petegaggs/MIDI-to-CV/MIDI-CV internals.jpg

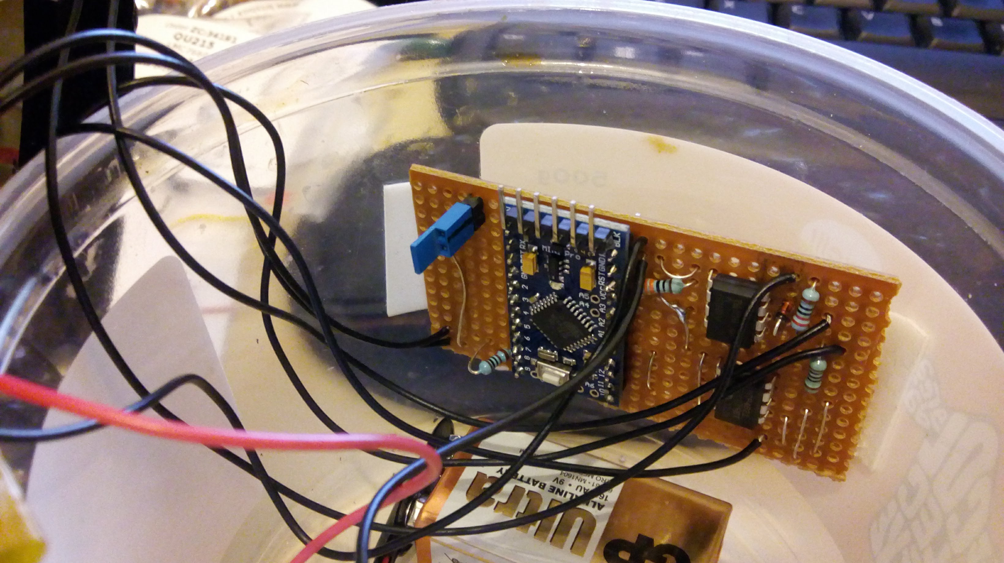
MIDI-CV internals.jpg
