petegaggs/MIDI-to-CV/midi_cv.jpg

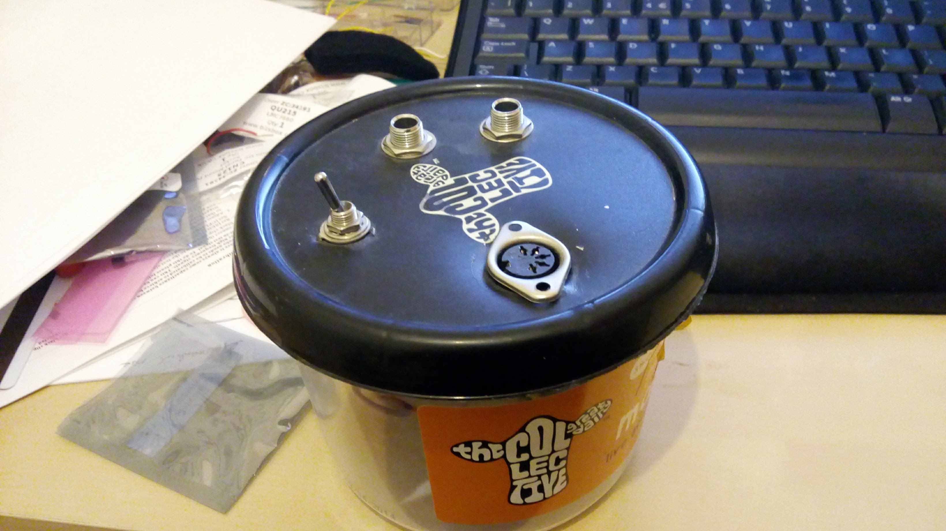
midi_cv.jpg
