petegaggs/MIDI-to-CV/README.md

# MIDI-to-CV
arduino based MIDI to CV converter
2 variants:
Original hardware was simple 1V/octave midi to CV converter
New version is combined Midi-CV plus AS3340 VCO module
