petegaggs/MIDI-to-CV/OSC_3340_A_BOM.xlsx

Description | Designator | Quantity | Supplier / Part Number
OSC_3340 Bill of Materials
rev A
Capacitors
Capacitor 0805 X7R 10% 50V 100nF | C1, C2, C3, C4, C8, C9, C10, C11, C12, C16 | 10
Capacitor Electrolytic 10uF 16V 5x11mm | C5, C6, C7 | 3
Capacitor 0805 X7R 10% 50V 10nF | C13, C17 | 2
Capacitor 0805 NPO 5% 100V 22pF | C14, C15 | 2
Capacitor Polyester WIMA FKS2 1nF 5% 100V | C18 | 1
Connectors
Jack socket 3.5mm mono | J1, J4, J7, J8, J9 | 5 | Soundtronics / 7212-239
Pin header 2.54mm pitch 1x6 way | J3 | 1
Jack socket 3.5mm stereo | J5 | 1 | Soundtronics / 7212-240
Pin header 2.54mm pitch 1x2 way | J6 | 1
Semiconductors
Diode 1N4148 | D1 | 1
Transistor NPN 2N3904 TO-92 | Q1 | 1
IC Quad Op-amp TL084 DIP-14 package | U1 | 1
IC Voltage Controlled Oscillator Alfa AS3340A DIP-16 pakage | U2 | 1 | Soundtronics / 7212-601
IC Adjustable Precision shunt regulator 1% TL431ACLP TO-92 | U3 | 1 | TI / TL431ACLP
Voltage regulator -5V LM79L05 TO92 package | U4 | 1
IC Microcontroller Atmel ATMEGA328P-PU | U5 | 1
IC 12-bit dual SPI DAC MCP4822-E/P | U6 | 1 | Microchip / MCP4822-E/P
IC 6N139M Opto Isolator DIP-8 | U7 | 1
Resistors
Resistor 0805 1% 0.125W 220R | R18 | 1
Resistor 0805 1% 0.125W 330R | R29 | 1
Resistor 0805 1% 0.125W 470R | R11, R13, R16, R32, R33, R35 | 6
Resistor 0805 1% 0.125W 1K8 | R17 | 1
Resistor 0805 1% 0.125W 2K | R8 | 1
Resistor 0805 1% 0.125W 3K3 | R7, R9 | 2
Resistor 0805 1% 0.125W 5K6 | R2 | 1
Resistor 0805 1% 0.125W 10K | R12, R25, R26, R27, R28, R34 | 6
Resistor 0805 1% 0.125W 15K | R22, R31 | 2
Resistor 0805 1% 0.125W 18K | R20, R24 | 2
Resistor 0805 1% 0.125W 24K | R1 | 1
Resistor 0805 1% 0.125W 30K | R21, R23, R30 | 3
Resistor 0805 1% 0.125W 33K | R19 | 1
Resistor 0805 1% 0.125W 51K | R10 | 1
Resistor 0805 1% 0.125W 91K | R14 | 1
Resistor 0805 1% 0.125W 100K | R3, R5 | 2
Resistor 0805 1% 0.125W 240K | R4 | 1
Resistor 0805 1% 0.125W 1M | R6, R15 | 2
Poteniometer 9mm 100K linear | RV1, RV4 | 2 | Soundtronics / 7300-785
Preset Potentiometer SIL vertical Bourns 3296W 10K | RV2 | 1 | Soundtronics / 7212-857
Preset Potentiometer SIL vertical Bourns 3296W 20K | RV3, RV5 | 2 | Soundtronics / 7212-858
Crystals
Crystal HC-49 16.000MHz low profile | Y1 | 1
