petegaggs/MIDI-to-CV/osc_3340_schematic_revA.pdf

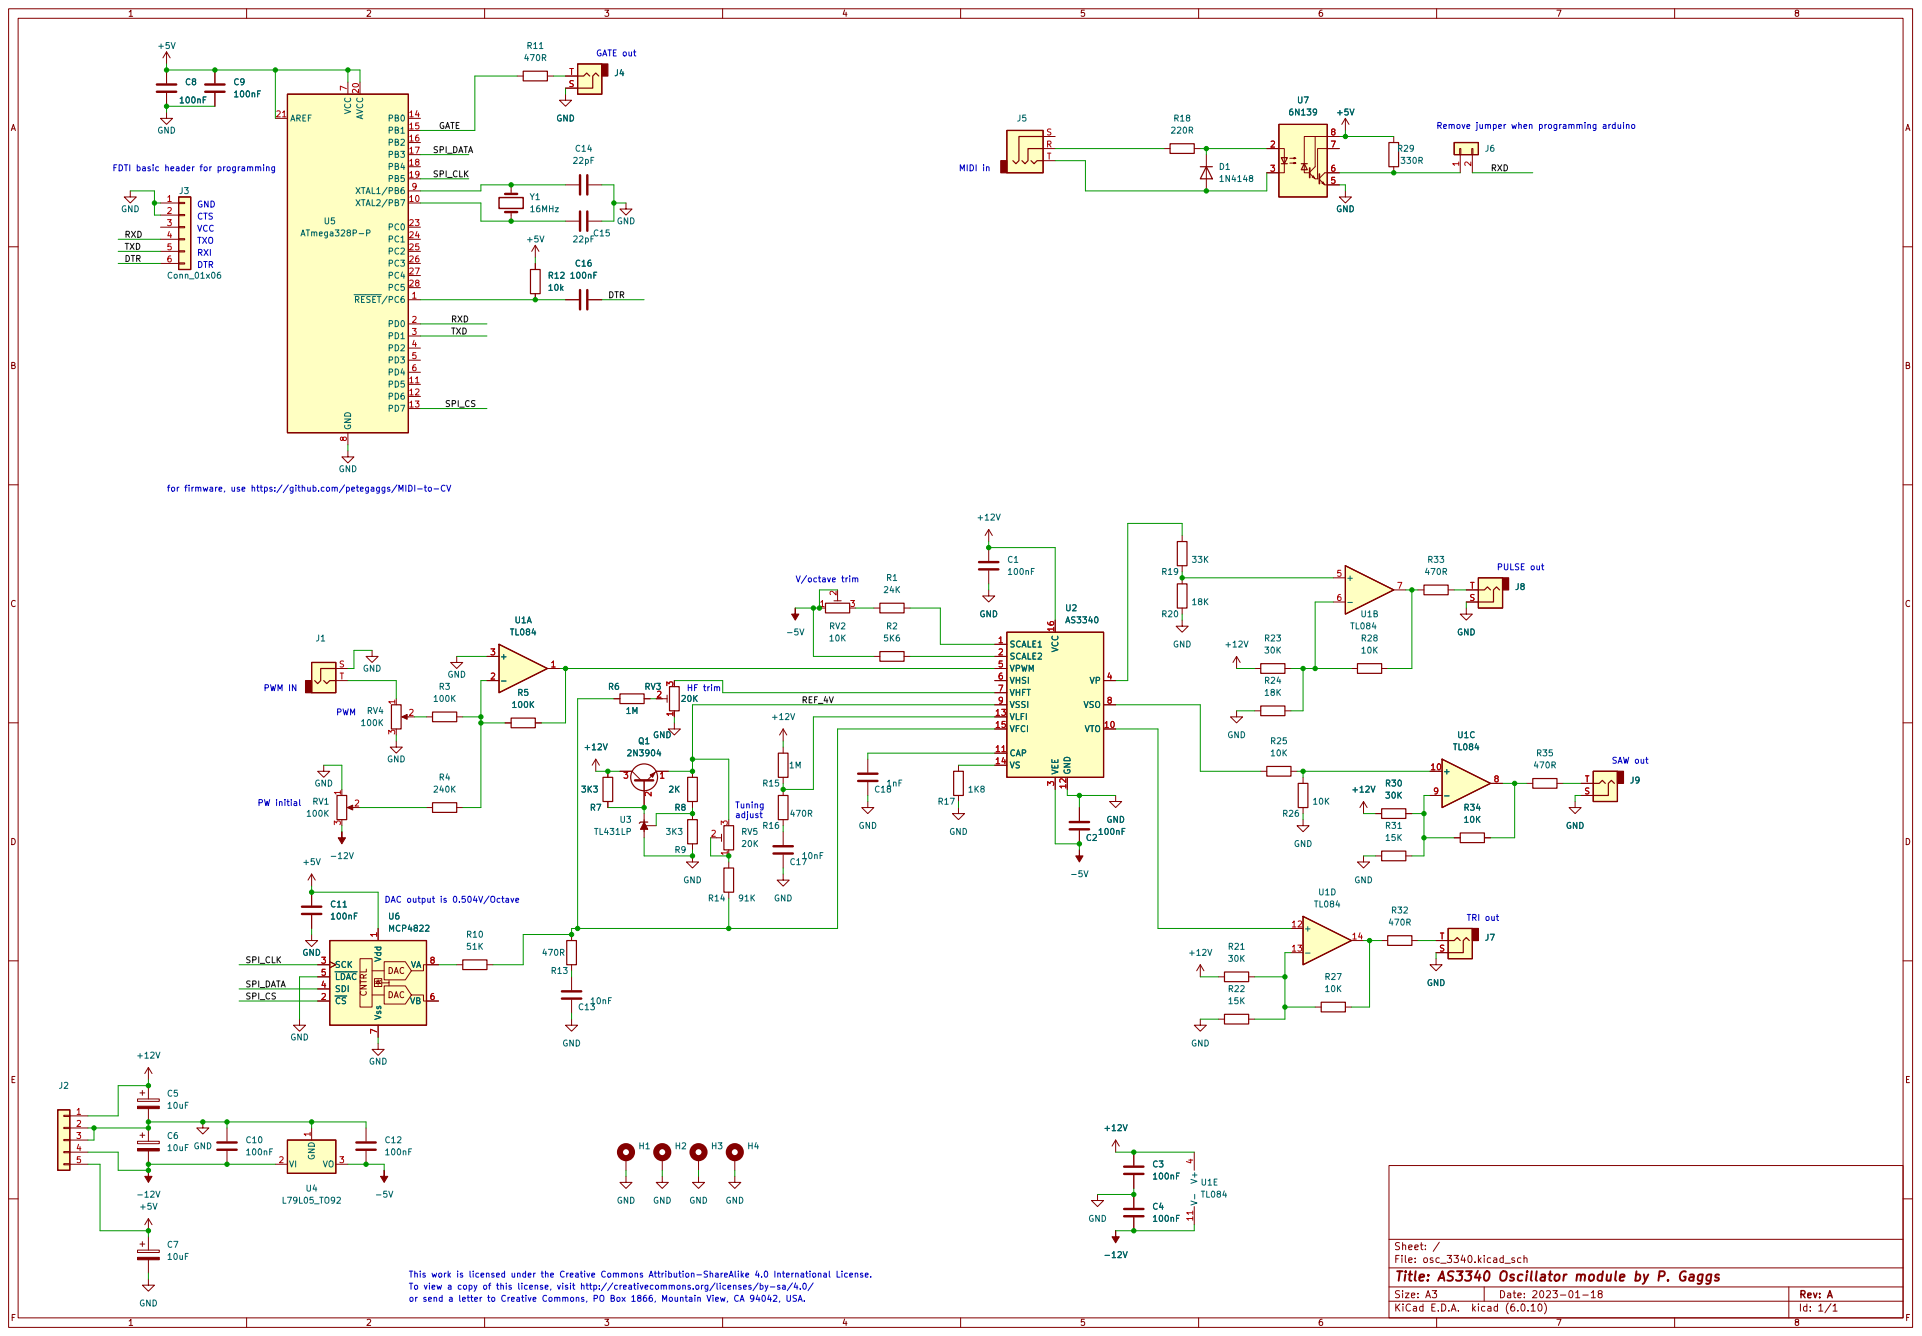
[picture p3: page 1]

Remove jumper when programming arduino GATE out

SPI_DATA RXD
FDTI basic header for programming

for firmware, use https://github.com/petegaggs/MIDI-to-CV

PULSE out PWM IN

TRI out V/octave trim

File: osc_3340.kicad_sch Sheet: /
Id: 1/1 Title: AS3340 Oscillator module by P. Gaggs

This work is licensed under the Creative Commons Attribution-ShareAlike 4.0 International License.
or send a letter to Creative Commons, PO Box 1866, Mountain View, CA 94042, USA. To view a copy of this license, visit http://creativecommons.org/licenses/by-sa/4.0/
