petegaggs/MIDI-to-CV/midi-cv.pdf

+5V

+5V

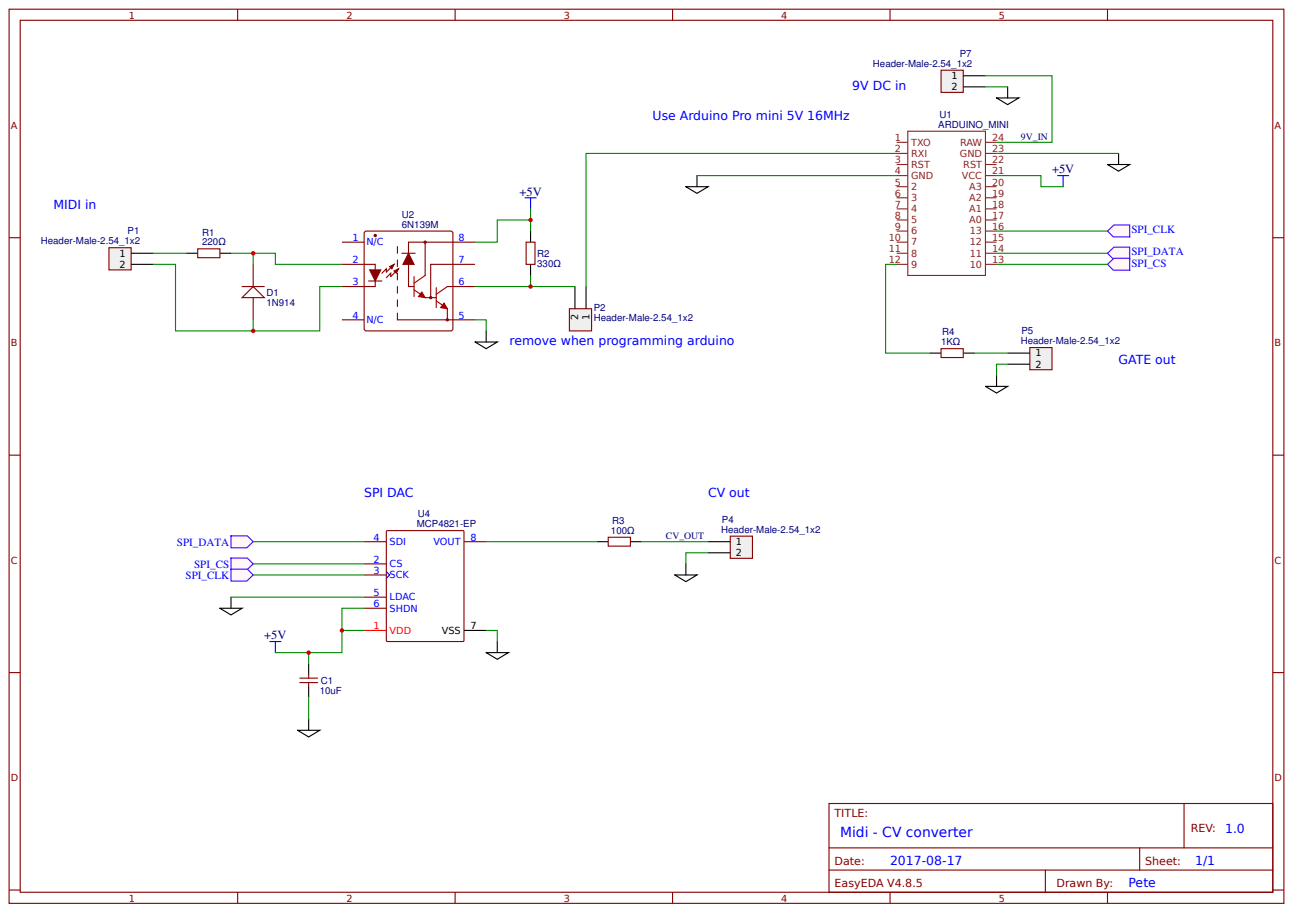
[picture p4: page 1]

Use Arduino Pro mini 5V 16MHz

remove when programming arduino
