petegaggs/MIDI-to-CV/osc_3340.kicad_pcb

## KiCad design osc_3340.kicad_pcb (2023-04-07)

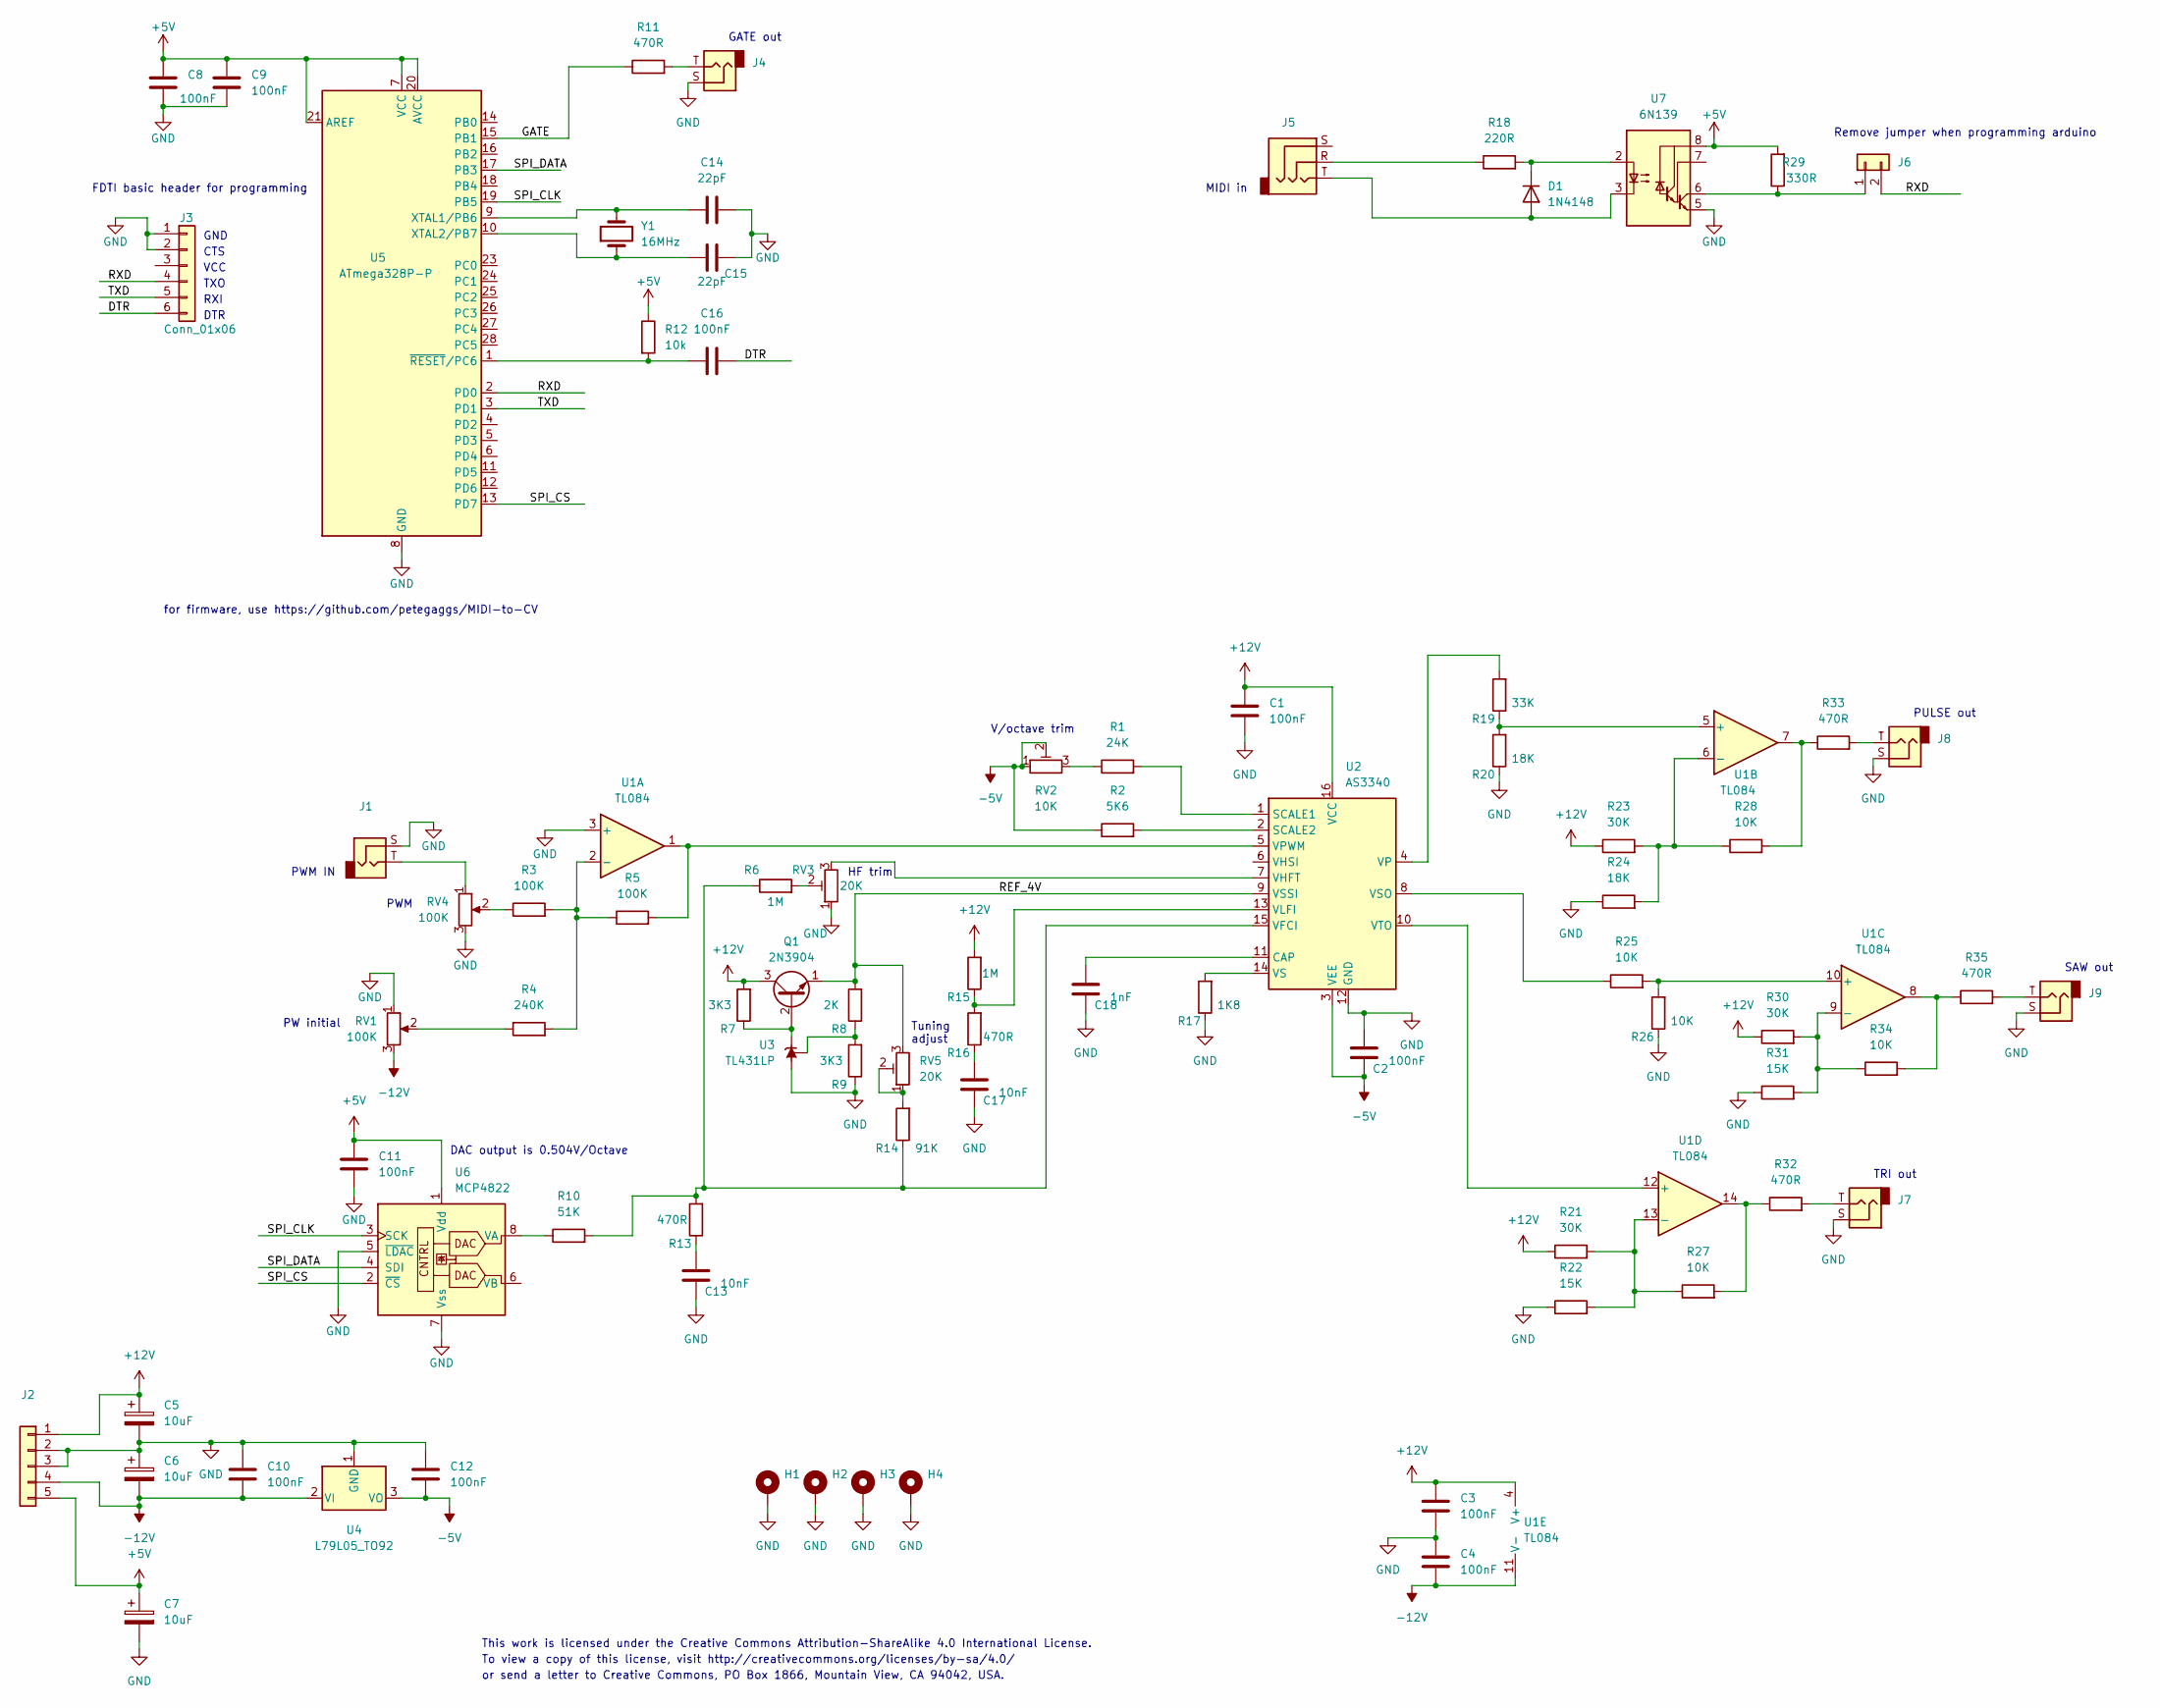
[picture p5: schematic osc_3340.kicad_sch, AS3340 Oscillator module by P. Gaggs]

Parts:
C1, C2, C3, C4, C8, C9, C10, C11, C12, C16: 100nF; C_0805_2012Metric_Pad1.18x1.45mm_HandSolder
C5, C6, C7: 10uF; CP_Radial_D5.0mm_P2.00mm
C13, C17: 10nF; C_0805_2012Metric_Pad1.18x1.45mm_HandSolder
C14, C15: 22pF; C_0805_2012Metric_Pad1.18x1.45mm_HandSolder
C18: 1nF; C_Disc_D6.0mm_W4.4mm_P5.00mm
D1: 1N4148; D_DO-35_SOD27_P7.62mm_Horizontal
H1, H2, H3, H4: MountingHole_Pad; MountingHole_3.2mm_M3_ISO7380_Pad
J1, J4, J7, J8, J9: AudioJack2; jack_3.5mm_mono_vertical_soundtronics_7212-239
J2: Conn_01x05; PinHeader_1x05_P2.54mm_Vertical
J3: Conn_01x06; PinHeader_1x06_P2.54mm_Vertical
J5: AudioJack3; jack_3.5mm_stereo_vertical_soundtronics_7212-240
J6: Conn_01x02; PinHeader_1x02_P2.54mm_Vertical
Q1: 2N3904; TO-92_Inline_Wide
R1: 24K; R_0805_2012Metric_Pad1.20x1.40mm_HandSolder
R2: 5K6; R_0805_2012Metric_Pad1.20x1.40mm_HandSolder
R3, R5: 100K; R_0805_2012Metric_Pad1.20x1.40mm_HandSolder
R4: 240K; R_0805_2012Metric_Pad1.20x1.40mm_HandSolder
R6, R15: 1M; R_0805_2012Metric_Pad1.20x1.40mm_HandSolder
R7, R9: 3K3; R_0805_2012Metric_Pad1.20x1.40mm_HandSolder
R8: 2K; R_0805_2012Metric_Pad1.20x1.40mm_HandSolder
R10: 51K; R_0805_2012Metric_Pad1.20x1.40mm_HandSolder
R11, R13, R16, R32, R33, R35: 470R; R_0805_2012Metric_Pad1.20x1.40mm_HandSolder
R12: 10k; R_0805_2012Metric_Pad1.20x1.40mm_HandSolder
R14: 91K; R_0805_2012Metric_Pad1.20x1.40mm_HandSolder
R17: 1K8; R_0805_2012Metric_Pad1.20x1.40mm_HandSolder
R18: 220R; R_0805_2012Metric_Pad1.20x1.40mm_HandSolder
R19: 33K; R_0805_2012Metric_Pad1.20x1.40mm_HandSolder
R20, R24: 18K; R_0805_2012Metric_Pad1.20x1.40mm_HandSolder
R21, R23, R30: 30K; R_0805_2012Metric_Pad1.20x1.40mm_HandSolder
R22, R31: 15K; R_0805_2012Metric_Pad1.20x1.40mm_HandSolder
R25, R26, R27, R28, R34: 10K; R_0805_2012Metric_Pad1.20x1.40mm_HandSolder
R29: 330R; R_0805_2012Metric_Pad1.20x1.40mm_HandSolder
RV1, RV4: 100K; Potentiometer_Alps_RK09K_Single_Vertical
RV2: 10K; Potentiometer_Bourns_3296W_Vertical
RV3, RV5: 20K; Potentiometer_Bourns_3296W_Vertical
U1: TL084; DIP-14_W7.62mm_Socket
U2: AS3340; DIP-16_W7.62mm_Socket
U3: TL431LP; TO-92_Inline_Wide
U4: L79L05_TO92; TO-92_Inline_Wide
U5: ATmega328P-P; DIP-28_W7.62mm
U6: MCP4822; DIP-8_W7.62mm_Socket
U7: 6N139; DIP-8_W7.62mm_Socket
Y1: 16MHz; Crystal_HC49-4H_Vertical

Connections:
+5V: C7.1, C8.1, C9.1, C11.1, J2.5, R12.1, R29.2, U5.7 (VCC), U5.20 (AVCC), U5.21 (AREF), U6.1 (Vdd), U7.8 (VCC)
+12V: C1.1, C3.1, C5.1, J2.1, Q1.3 (C), R7.2, R15.2, R21.1, R23.1, R30.1, U1.4 (V+), U2.16 (VCC)
-5V: C2.2, C12.2, R2.1, RV2.1, RV2.2, U2.3 (VEE), U4.3 (VO)
-12V: C4.2, C6.2, C10.2, J2.4, RV1.3, U1.11 (V-), U4.2 (VI)
/DTR: C16.2, J3.6
/GATE: R11.1, U5.15 (PB1)
/REF_4V: Q1.1 (E), R8.2, RV5.3, U2.9 (VSSI)
/RXD: J3.4, J6.2, U5.2 (PD0)
/SPI_CLK: U5.19 (PB5), U6.3 (SCK)
/SPI_CS: U5.13 (PD7), U6.2 (~CS)
/SPI_DATA: U5.17 (PB3), U6.4 (SDI)
/TXD: J3.5, U5.3 (PD1)
GND: C1.2, C2.1, C3.2, C4.1, C5.2, C6.1, C7.2, C8.2, C9.2, C10.1, C11.2, C12.1, C13.2, C14.2, C15.2, C17.2, C18.2, H1.1, H2.1, H3.1, H4.1, J1.S, J2.2, J2.3, J3.1, J3.2, J4.S, J7.S, J8.S, J9.S, R9.1, R17.1, R20.1, R22.1, R24.1, R26.1, R31.1, RV1.1, RV3.1, RV4.3, U1.3 (+), U2.12 (GND), U3.2 (A), U4.1 (GND), U5.8 (GND), U5.22 (GND), U6.5 (~LDAC), U6.7 (Vss), U7.5 (GND)
unnamed: C13.1, R13.1
unnamed: C14.1, U5.9 (XTAL1/PB6), Y1.2
unnamed: C15.1, U5.10 (XTAL2/PB7), Y1.1
unnamed: C16.1, R12.2, U5.1 (~RESET/PC6)
unnamed: C17.1, R16.1
unnamed: C18.1, U2.11 (CAP)
unnamed: D1.1 (K), R18.2, U7.2 (C1)
unnamed: D1.2 (A), J5.T, U7.3 (C2)
unnamed: J1.T, RV4.1
unnamed: J4.T, R11.2
unnamed: J5.R, R18.1
unnamed: J6.1, R29.1, U7.6 (VO2)
unnamed: J7.T, R32.2
unnamed: J8.T, R33.2
unnamed: J9.T, R35.2
unnamed: Q1.2 (B), R7.1, U3.3 (K)
unnamed: R1.1, RV2.3
unnamed: R1.2, U2.1 (SCALE1)
unnamed: R2.2, U2.2 (SCALE2)
unnamed: R3.1, RV4.2
unnamed: R3.2, R4.2, R5.1, U1.2 (-)
unnamed: R4.1, RV1.2
unnamed: R5.2, U1.1, U2.5 (VPWM)
unnamed: R6.2, RV3.2
unnamed: R8.1, R9.2, U3.1 (REF)
unnamed: R10.1, U6.8 (VA)
unnamed: R6.1, R10.2, R13.2, R14.1, U2.15 (VFCI)
unnamed: R14.2, RV5.1, RV5.2
unnamed: R15.1, R16.2, U2.13 (VLFI)
unnamed: R17.2, U2.14 (VS)
unnamed: R19.1, R20.2, U1.5 (+)
unnamed: R19.2, U2.4 (VP)
unnamed: R21.2, R22.2, R27.1, U1.13 (-)
unnamed: R23.2, R24.2, R28.1, U1.6 (-)
unnamed: R25.1, U2.8 (VSO)
unnamed: R25.2, R26.2, U1.10 (+)
unnamed: R27.2, R32.1, U1.14
unnamed: R28.2, R33.1, U1.7
unnamed: R30.2, R31.2, R34.1, U1.9 (-)
unnamed: R34.2, R35.1, U1.8
unnamed: RV3.3, U2.7 (VHFT)
unnamed: U1.12 (+), U2.10 (VTO)

Notes on the sheet:
HF trim
PWM IN
FDTI basic header for programming
for firmware, use https://github.com/petegaggs/MIDI-to-CV
GATE out
GND
V/octave trim
Tuning adjust
VCC
This work is licensed under the Creative Commons Attribution-ShareAlike 4.0 International License.
RXI
DAC output is 0.504V/Octave
TRI out
PW initial
TXO
SAW out
PWM
Remove jumper when programming arduino
or send a letter to Creative Commons, PO Box 1866, Mountain View, CA 94042, USA.
To view a copy of this license, visit http://creativecommons.org/licenses/by-sa/4.0/
PULSE out
DTR
MIDI in
CTS

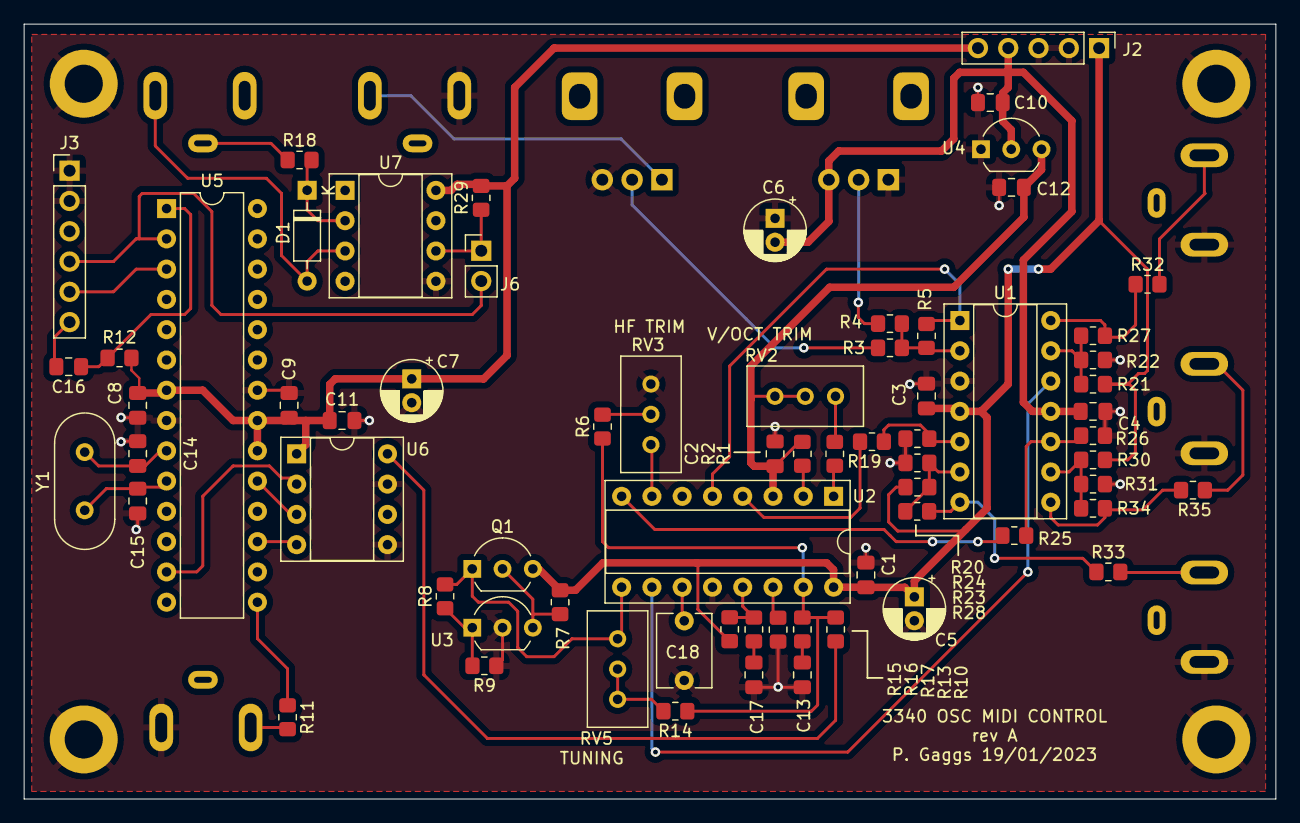
[picture p6: board osc_3340.kicad_pcb from above]

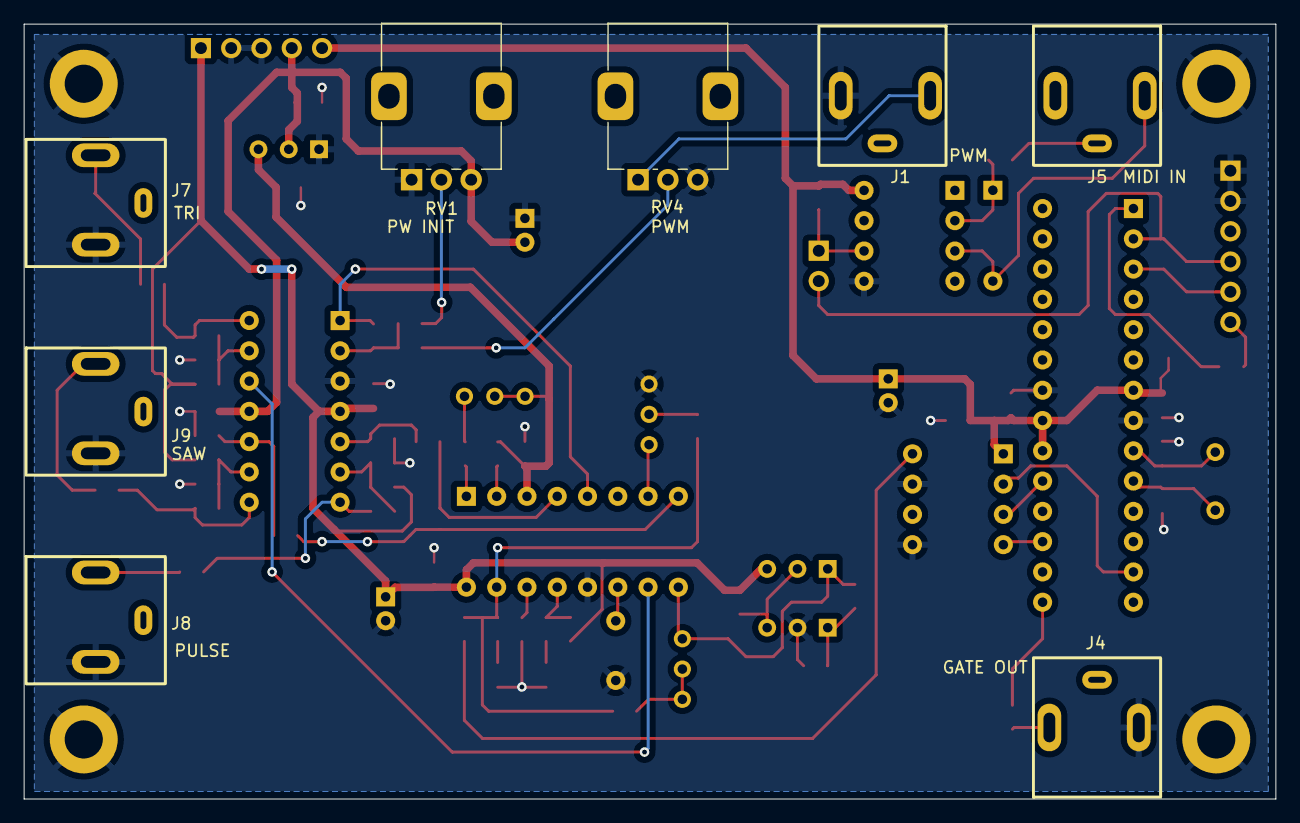
[picture p7: board osc_3340.kicad_pcb from below]

Board: 2 copper layers, 105.0 x 65.0 mm, 81 parts (8 on the bottom side), 55 nets.
