petegaggs/MIDI-to-CV/(notices)

Notices in the files:
midi_cv2.ino:
MIT License
Copyright (c) 2023 Peter Gaggs
